MarcinanProfesjonalista/ESP8266-PNP-Sensor-counter/Schematic_ESP8266 PNP Proximity with N Mosfet_2021-01-15.png

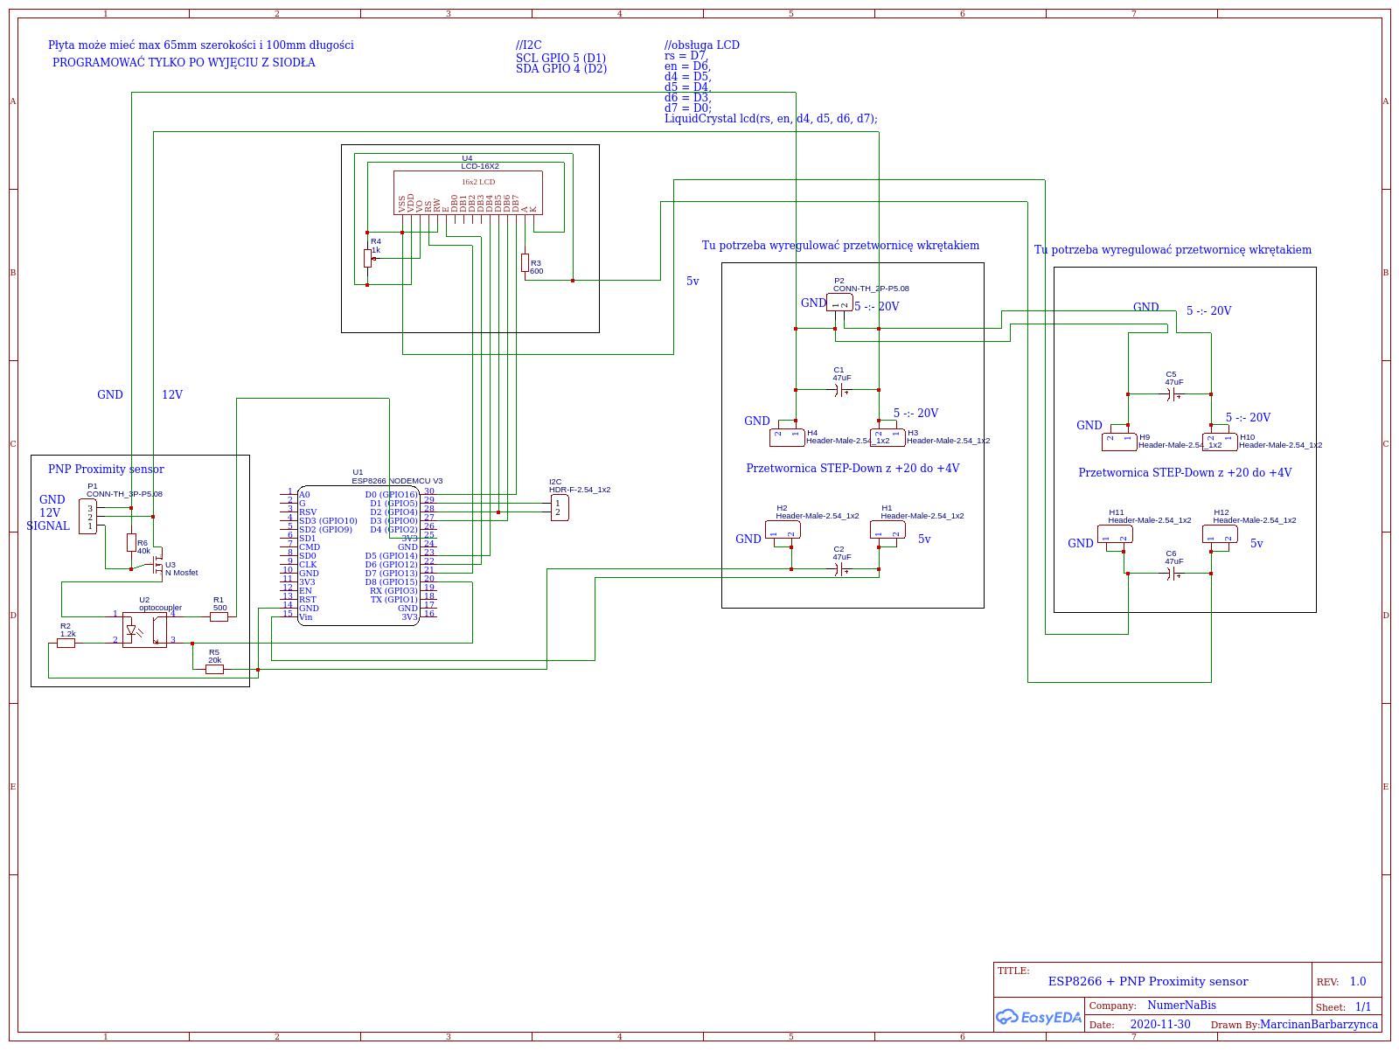
Schematic_ESP8266 PNP Proximity with N Mosfet_2021-01-15.png
