MarcinanProfesjonalista/ESP8266-PNP-Sensor-counter/(commit log)

2021-01-15 Dodanie schematu wersji V3
    Jest to schemat użyty przy czujnikach laserowych 2-3-4-5
2021-08-02 Nowa wersja klienta ESP8266
    Wywaliłem WIFI MULTI. Dodałem obsługę drugiego LEDA wbudowanego w NODEMCU. Uprościłem procedurę odnowy połączenia. Drugi led sygnalizuje utratę WIFI.
